mastersta/wave-timer/(commit log)

2018-04-25 implement 7seg display to show time remaining in current cycle
    using adafruit HT16K33 backpack and 4 digit 7seg display; clock on pin A5, data on pin A4
2018-04-29 implement single dip switch cycle time
    Each side of the cycle can now have its time set (in minutes) via a single 8-bit dip switch. The 4 most significant bits are dedicated to the on time, and the 4 least significant bits are dedicated to the off time. Values are read in traditional binary fashion, which forces a maximum value of 15 minutes for either side of the cycle.
    Clock on pin D4, load on pin D5, data in on pin 6.
2018-06-08 disable time input due to hardware bugs, alter button input pins due to hardware mistake
2018-06-09 WIP adding outdoor timer display
2018-07-10 implement 12v alarm bell via relay on pin 6
2018-07-19 add readme and circuit diagram
2018-07-20 fix cycle time bug
    [wave_controller.ino]
2018-07-22 implement built-in watchdog timer
